rocketpie/tinyups/docs/architecture.md

# TinyUPS – Architecture (Draft)

> Status: **Draft.** Block topology is fixed by the design interview
> (see `docs/requirements.md`); component selection is still open.

## Block diagram

```mermaid
flowchart LR
    IN["A: 12 V in (XT60)\nexternal 240 W adapter"] --> PROT["Input protection\nfuse · TVS · OVP · reverse"]
    PROT --> PPM["Priority power path\ninput overrides pack"]
    PROT --> CHG["4S LFP charger\nbuck-boost CC/CV 13.8 V"]
    CHG <--> PACK["B: 4S1P LFP pack\n15 Ah + AFE/BMS"]
    PACK --> PPM
    PPM --> CONV["12 V buck-boost\nregulated 12.0 V"]
    CONV --> OUT["C: XT30 → 5.5×2.5 barrel\n→ picoPSU-160-XT"]
    AFE["AFE\ncell V · pack I · T\nbalancing · FETs"] <--> PACK
    AFE <--> MCU["RP2040\nSOC · logic · safety"]
    MCU --> USB["D: USB-C\nCDC + HID-PDC"]
    MCU --> IND["LEDs + reset button"]
    MCU --> FAN["80 mm fan\n4-pin: 12 V/PWM/tach"]
```

## Why this topology

- **Priority power path, not an ideal-diode OR.** A charged 4S LFP pack
  (~13.8 V) is *higher* than the 12 V input. A passive OR would let the pack
  supply the load even on mains and cycle the battery. The path must actively
  prefer the input whenever it is valid.
- **Always-regulated 12 V output.** The pack ranges from ~11.2 V to 13.8 V, so
  a buck-boost keeps the picoPSU inside its 10.8–13.2 V window at all times and
  hides adapter sag.
- **Buck-boost charger.** The pack sits both above and below 12 V depending on
  SOC, so a boost-only charger cannot regulate a low pack; a 4-switch
  buck-boost covers the whole range.
- **Two independent paths on mains** (load from input, pack charged in
  parallel) keep the transfer seamless and let the 20 A adapter run the load
  and charge simultaneously.
- **Pack-integrated BMS.** Per-cell sensing, protection and balancing live on
  the PCB so the module is self-contained and reports richer telemetry.

## Functional blocks

| Power Flow Order | Block | Task | Candidates |
| --- | --- | --- | --- |
| 1 | Input protection | Fuse, reverse-polarity, OVP, transient | Fuse + TVS + P-FET / eFuse |
| 2 | Charger | 4S LFP CC/CV to 13.8 V, temp-limited | 4-switch buck-boost charger IC |
| 3 | Priority power path | Prefer input, disconnect pack on mains | Power mux / back-to-back FETs + controller |
| 4 | Battery management | Cell V, pack I, T, balancing, protection FETs | BQ769x2-class AFE + dual N-FETs |
| 5 | Output converter | Regulated 12.0 V, ≥ 15 A | Synchronous buck-boost controller |
| 6 | Measurement | Output V/I, temperatures | AFE / INA226 + NTC |
| 6 | MCU | SOC, state machine, telemetry, signalling | RP2040 + QSPI flash |
| 6 | Host link | Telemetry + low-battery shutdown | USB-C composite CDC + HID-PDC |
| 6 | User interface | Status indication, reset | LEDs + button |
| 6 | Cooling | Temperature-controlled airflow | 80 mm fan, on-board 4-pin header |

ref: blocks.py

## Modes

1. **Mains, pack charged** – load from input, pack idle/float.
2. **Mains, pack charging** – load from input, charger in CC or CV.
3. **Backup** – input absent, pack feeds the buck-boost, no host reset.
4. **Low battery** – host warned at ≤ 30 % SOC; force-off at 3.0 V/cell.
5. **Off / storage** – output disabled, ≤ 1 mA from pack.

## Placement intent

Placement follows a written contract, not the netlist:
[`hardware/placement_spec.py`](../hardware/placement_spec.py) gives every part
a role and the limits (host, min/max, measure, reason) that follow from its
circuit function.  The power path is ordered input → protection → priority
path → converter → output; the charger and BMS are separate loops; switching
cells stay tight, the AFE/crystal/USB/harness stay away from the magnetics.
`make proximity` measures the board against it and `make place` uses the same
limits.  The measures, target families and per-block table are in
[`docs/placement.md`](placement.md); the decision is
[ADR-0016](decisions/0016-placement-intent.md).

The report prints every violated group and writes `reports/proximity.rpt`.  It
is a screen, not a CI gate by default; pass `--strict` to make it exit non-zero
(a missing role or host is always an error).

## Directory structure (planned)

```
hardware/
  tinyups.kicad_pro      # KiCad project
  tinyups.kicad_sch      # schematic (source of truth)
  tinyups.kicad_pcb      # board (source of truth)
  tinyups.kicad_dru      # design rules (JLCPCB)
  libs/                  # custom symbols
  blocks.py              # functional-block / reference map
  placement_spec.py      # roles + placement limits (design intent)
  power_*.py             # power spec, map, ampacity, pour, channel
  route.py               # FreeRouting driver
  route_feedback.py      # routed board + DRC -> placement-UI feedback JSON
ui/
  placement/             # interactive placement UI (browser)
mechanical/
  enclosure/             # ATX-bay enclosure (STEP/STL)
firmware/
  ...                    # RP2040 firmware (Pico SDK / PlatformIO)
sim/
  *.cir                  # ngspice netlists
tests/
  test_*.py              # pytest + PyVISA bring-up / acceptance
docs/
  requirements.md
  architecture.md
  bom.md
  test-plan.md
  history/layout_poc/    # archived automatic-placement PoC
  datasheets/            # vendor datasheets + source register
  decisions/
```

## Key design decisions

- Priority (active) power path instead of ideal-diode OR.
- Separate loops for charging and output conversion.
- Pack-integrated AFE for telemetry and safety.
- Telemetry and shutdown on a dedicated MCU, independent of host software.
- USB composite device: CDC for tooling, HID-PDC for native OS/NUT support.
- All checks headless via CLI (`kicad-cli`, KiBot, ngspice) for CI and
  agent support.

See `docs/decisions/0002`–`0006` for the recorded choices.
