rocketpie/tinyups/hardware/tinyups.kicad_pcb

## KiCad design hardware/tinyups.kicad_pcb (2026-10-20)

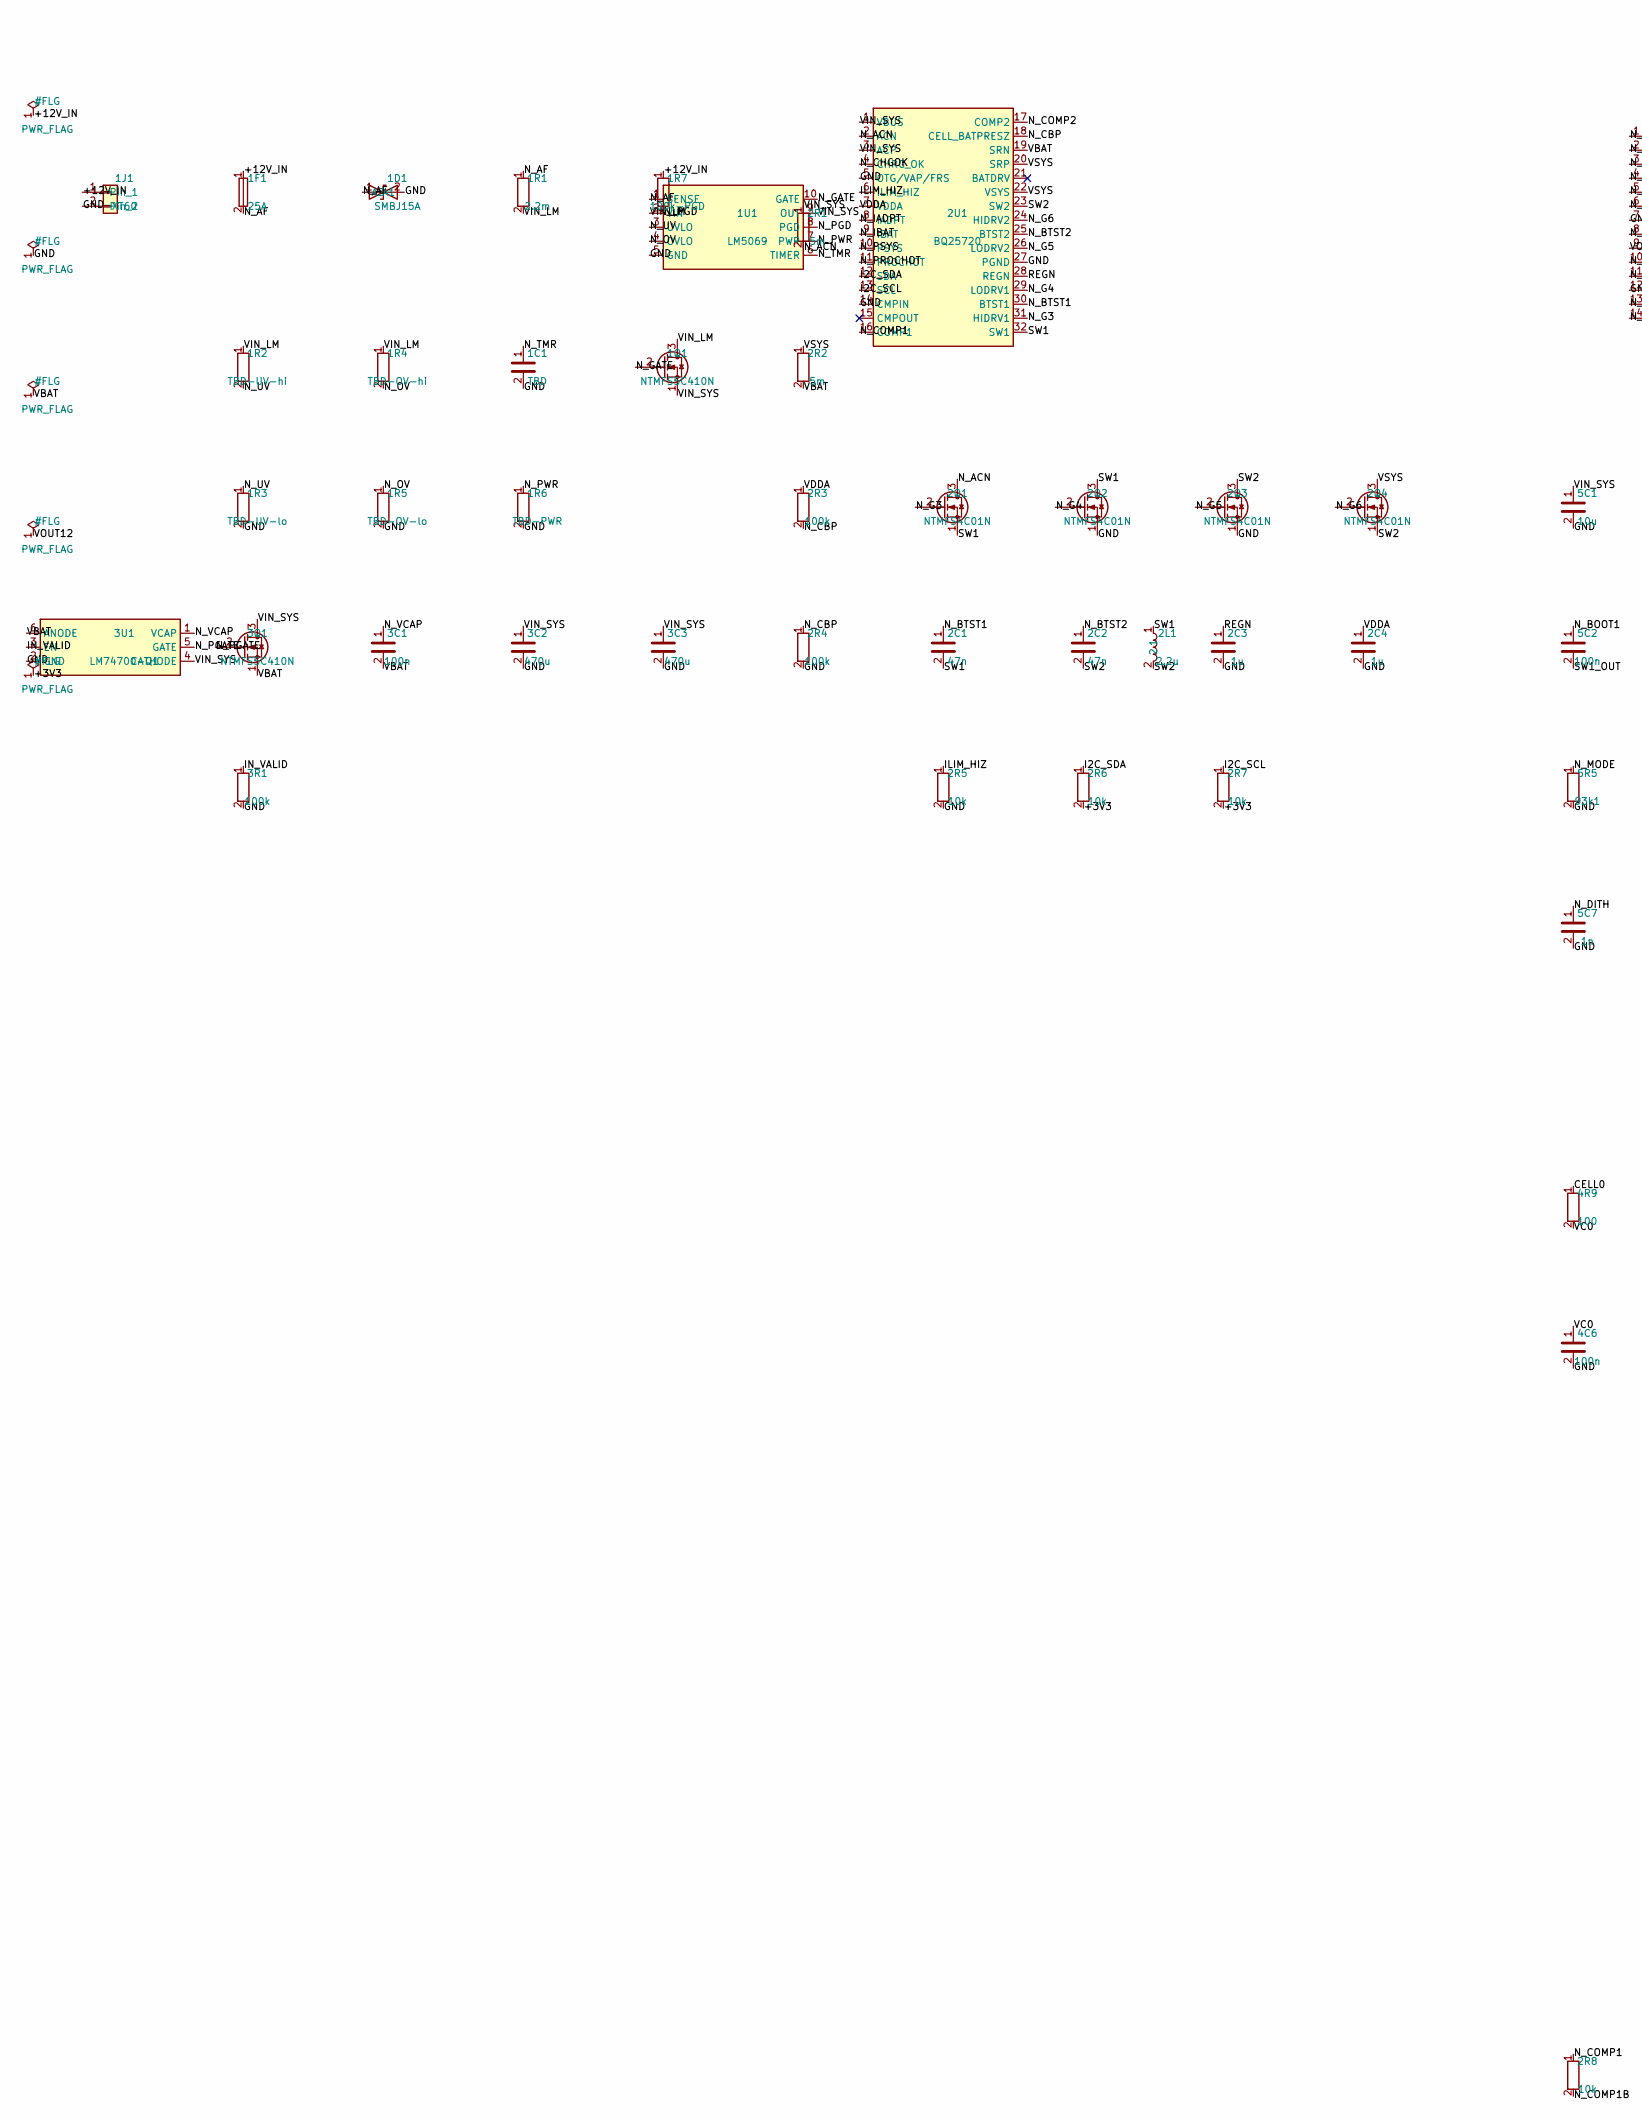
[picture p1: schematic tinyups.kicad_sch, part in row 1, column 1]

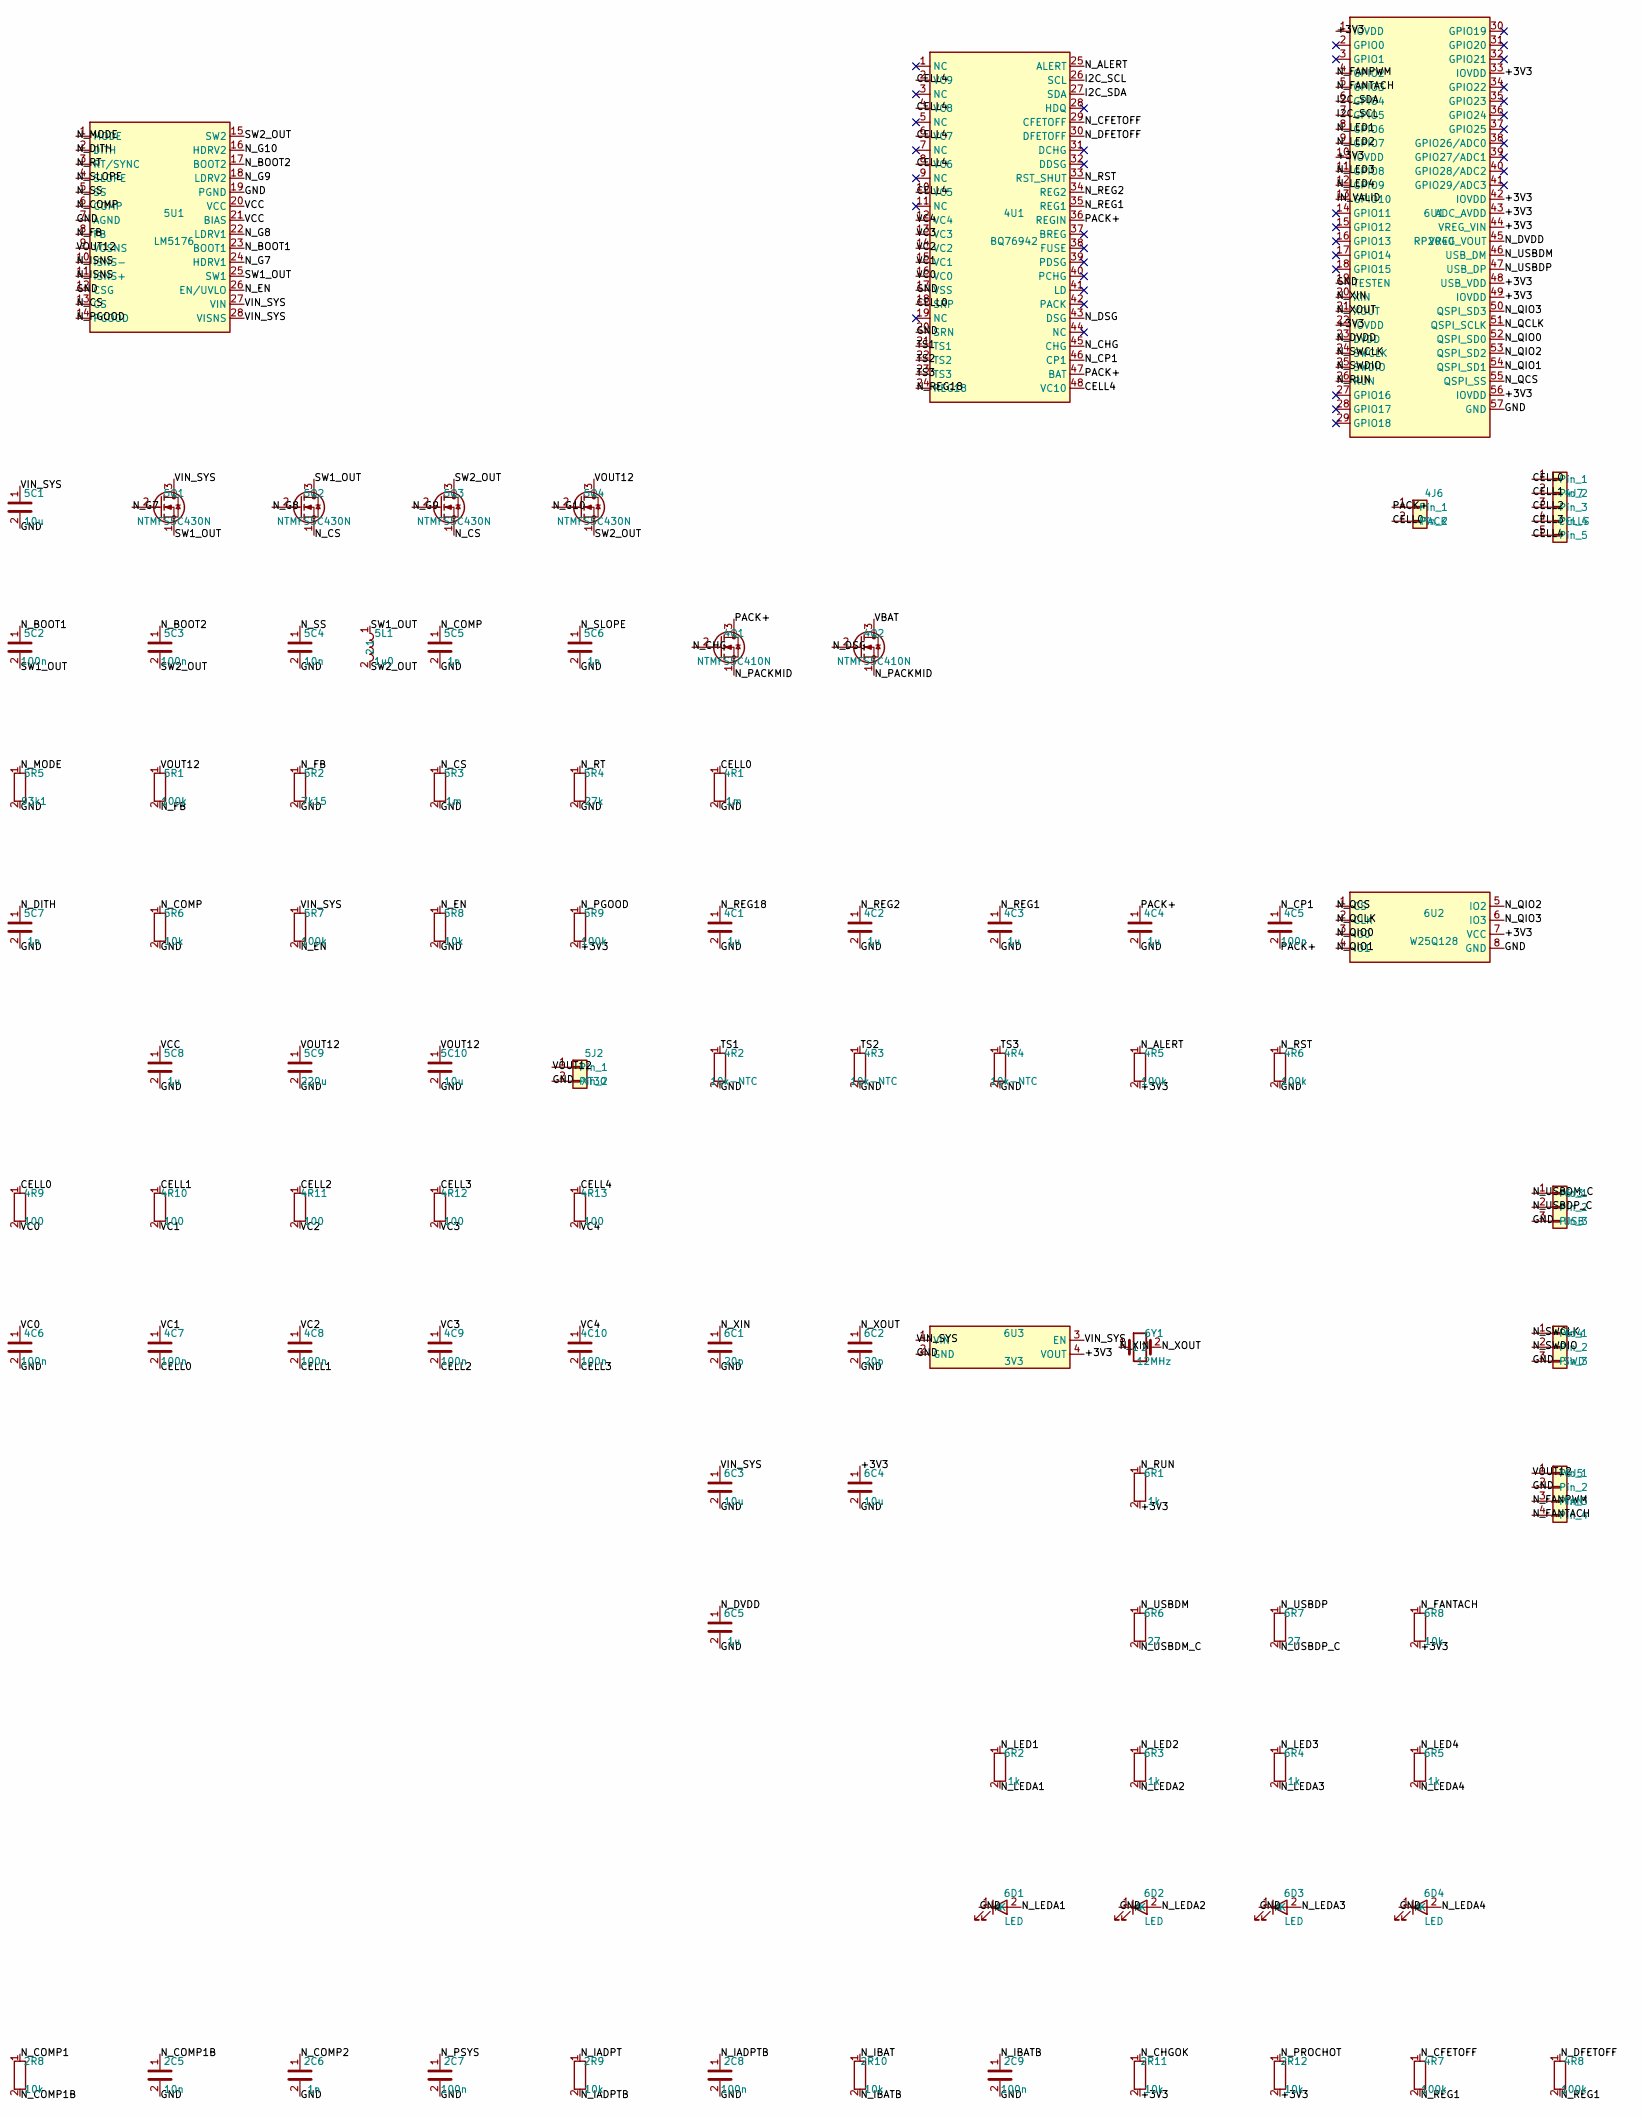
[picture p2: schematic tinyups.kicad_sch, part in row 1, column 2]

Parts:
1C1: TBD; C_0805_2012Metric
1D1: SMBJ15A; D_SMB
1F1: 25A; Fuse_Blade_ATO_directSolder
1J1: XT60; SolderWire-2.5sqmm_1x02_P8.8mm_D2.4mm_OD4.4mm
1Q1, 3Q1, 4Q1, 4Q2: NTMFS5C410N; VSONP-8-1EP_5x6_P1.27mm
1R1: 2.2m; R_Shunt_Vishay_WSR2_WSR3
1R2: TBD-UV-hi; R_0805_2012Metric
1R3: TBD-UV-lo; R_0805_2012Metric
1R4: TBD-OV-hi; R_0805_2012Metric
1R5: TBD-OV-lo; R_0805_2012Metric
1R6: TBD-PWR; R_0805_2012Metric
1R7: 100k-PGD; R_0805_2012Metric
1U1: LM5069; VSSOP-10_3x3mm_P0.5mm
2C1, 2C2: 47n; C_0805_2012Metric
2C3, 2C4, 4C1, 4C2, 4C3, 4C4, 5C8, 6C5: 1u; C_0805_2012Metric
2C5, 5C4: 10n; C_0805_2012Metric
2C6, 5C5, 5C6, 5C7: 1n; C_0805_2012Metric
2C7, 2C8, 2C9, 3C1, 4C5, 4C6, 4C7, 4C8, 4C9, 4C10, 5C2, 5C3: 100n; C_0805_2012Metric
2L1: 2.2u; L_12x12mm_H8mm
2Q1, 2Q2, 2Q3, 2Q4: NTMFS4C01N; VSONP-8-1EP_5x6_P1.27mm
2R1, 2R2: 5m; R_Shunt_Vishay_WSR2_WSR3
2R3, 2R4, 3R1, 4R5, 4R6, 4R7, 4R8, 5R1, 5R7, 5R9: 100k; R_0805_2012Metric
2R5, 2R6, 2R7, 2R8, 2R9, 2R10, 2R11, 2R12, 5R6, 5R8, 6R8: 10k; R_0805_2012Metric
2U1: BQ25720; QFN-32-1EP_4x4mm_P0.4mm_EP2.65x2.65mm
3C2, 3C3: 470u; CP_Elec_8x10
3U1: LM74700-Q1; SOT-23-6
4J6: PACK; SolderWire-2.5sqmm_1x02_P8.8mm_D2.4mm_OD4.4mm
4J7: CELLS; PinHeader_1x05_P2.54mm_Vertical
4R1, 5R3: 1m; R_Shunt_Vishay_WSR2_WSR3
4R2, 4R3, 4R4: 10k-NTC; R_0805_2012Metric
4R9, 4R10, 4R11, 4R12, 4R13: 100; R_0805_2012Metric
4U1: BQ76942; TQFP-48_7x7mm_P0.5mm
5C1, 5C10, 6C3, 6C4: 10u; C_0805_2012Metric
5C9: 220u; CP_Elec_8x10
5J2: XT30; SolderWire-2.5sqmm_1x02_P7.2mm_D2.4mm_OD3.6mm
5L1: 1u0; L_12x12mm_H8mm
5Q1, 5Q2, 5Q3, 5Q4: NTMFS5C430N; VSONP-8-1EP_5x6_P1.27mm
5R2: 7k15; R_0805_2012Metric
5R4: 27k; R_0805_2012Metric
5R5: 93k1; R_0805_2012Metric
5U1: LM5176; QFN-28-1EP_4x4mm_P0.4mm_EP2.4x2.4mm
6C1, 6C2: 20p; C_0805_2012Metric
6D1, 6D2, 6D3, 6D4: LED; LED_0805_2012Metric
6J3: USB; PinHeader_1x03_P2.54mm_Vertical
6J4: SWD; PinHeader_1x03_P2.54mm_Vertical
6J5: FAN; PinHeader_1x04_P2.54mm_Vertical
6R1, 6R2, 6R3, 6R4, 6R5: 1k; R_0805_2012Metric
6R6, 6R7: 27; R_0805_2012Metric
6U1: RP2040; QFN-56-1EP_7x7mm_P0.4mm_EP3.2x3.2mm
6U2: W25Q128; SOIC-8_3.9x4.9mm_P1.27mm
6U3: 3V3; SOT-23-5
6Y1: 12MHz; Crystal_SMD_5032-2Pin_5.0x3.2mm

Connections:
/+3V3: 2R6.2, 2R7.2, 2R11.2, 2R12.2, 4R5.2, 5R9.2, 6C4.1, 6R1.2, 6R8.2, 6U1.1 (IOVDD), 6U1.10 (IOVDD), 6U1.22 (IOVDD), 6U1.33 (IOVDD), 6U1.42 (IOVDD), 6U1.43 (ADC_AVDD), 6U1.44 (VREG_VIN), 6U1.48 (USB_VDD), 6U1.49 (IOVDD), 6U1.56 (IOVDD), 6U2.7 (VCC), 6U3.4 (VOUT)
/+12V_IN: 1F1.1, 1J1.1, 1R7.1
/CELL0: 4C7.2, 4J6.2, 4J7.1, 4R1.1, 4R9.1, 4U1.18 (SRP)
/CELL1: 4C8.2, 4J7.2, 4R10.1
/CELL2: 4C9.2, 4J7.3, 4R11.1
/CELL3: 4C10.2, 4J7.4, 4R12.1
/CELL4: 4J7.5, 4R13.1, 4U1.2 (VC9), 4U1.4 (VC8), 4U1.6 (VC7), 4U1.8 (VC6), 4U1.10 (VC5), 4U1.48 (VC10)
/GND: 1C1.2, 1D1.2 (A2), 1J1.2, 1R3.2, 1R5.2, 1R6.2, 1U1.5 (GND), 2C3.2, 2C4.2, 2C5.2, 2C6.2, 2C7.2, 2C8.2, 2C9.2, 2Q2.1 (S), 2Q3.1 (S), 2R4.2, 2R5.2, 2U1.5 (OTG/VAP/FRS), 2U1.14 (CMPIN), 2U1.27 (PGND), 3C2.2, 3C3.2, 3R1.2, 3U1.2 (GND), 4C1.2, 4C2.2, 4C3.2, 4C4.2, 4C6.2, 4R1.2, 4R2.2, 4R3.2, 4R4.2, 4R6.2, 4U1.17 (VSS), 4U1.20 (SRN), 5C1.2, 5C4.2, 5C5.2, 5C6.2, 5C7.2, 5C8.2, 5C9.2, 5C10.2, 5J2.2, 5R2.2, 5R3.2, 5R4.2, 5R5.2, 5R6.2, 5R8.2, 5U1.7 (AGND), 5U1.12 (CSG), 5U1.19 (PGND), 6C1.2, 6C2.2, 6C3.2, 6C4.2, 6C5.2, 6D1.1 (K), 6D2.1 (K), 6D3.1 (K), 6D4.1 (K), 6J3.3, 6J4.3, 6J5.2, 6U1.19 (TESTEN), 6U1.57 (GND), 6U2.8 (GND), 6U3.2 (GND)
/I2C_SCL: 2R7.1, 2U1.13 (SCL), 4U1.26 (SCL), 6U1.7 (GPIO5)
/I2C_SDA: 2R6.1, 2U1.12 (SDA), 4U1.27 (SDA), 6U1.6 (GPIO4)
/ILIM_HIZ: 2R5.1, 2U1.6 (ILIM_HIZ)
/IN_VALID: 3R1.1, 3U1.3 (EN), 6U1.13 (GPIO10)
/N_ACN: 2Q1.3 (D), 2R1.2, 2U1.2 (ACN)
/N_AF: 1D1.1 (A1), 1F1.2, 1R1.1, 1U1.1 (SENSE)
/N_ALERT: 4R5.1, 4U1.25 (ALERT)
/N_BOOT1: 5C2.1, 5U1.23 (BOOT1)
/N_BOOT2: 5C3.1, 5U1.17 (BOOT2)
/N_BTST1: 2C1.1, 2U1.30 (BTST1)
/N_BTST2: 2C2.1, 2U1.25 (BTST2)
/N_CBP: 2R3.2, 2R4.1, 2U1.18 (CELL_BATPRESZ)
/N_CFETOFF: 4R7.1, 4U1.29 (CFETOFF)
/N_CHG: 4Q1.2 (G), 4U1.45 (CHG)
/N_CHGOK: 2R11.1, 2U1.4 (CHRG_OK)
/N_COMP: 5C5.1, 5R6.1, 5U1.6 (COMP)
/N_COMP1: 2R8.1, 2U1.16 (COMP1)
/N_COMP1B: 2C5.1, 2R8.2
/N_COMP2: 2C6.1, 2U1.17 (COMP2)
/N_CP1: 4C5.1, 4U1.46 (CP1)
/N_CS: 5Q2.1 (S), 5Q3.1 (S), 5R3.1, 5U1.13 (CS)
/N_DFETOFF: 4R8.1, 4U1.30 (DFETOFF)
/N_DITH: 5C7.1, 5U1.2 (DITH)
/N_DSG: 4Q2.2 (G), 4U1.43 (DSG)
/N_DVDD: 6C5.1, 6U1.23 (DVDD), 6U1.45 (VREG_VOUT)
/N_EN: 5R7.2, 5R8.1, 5U1.26 (EN/UVLO)
/N_FANPWM: 6J5.3, 6U1.4 (GPIO2)
/N_FANTACH: 6J5.4, 6R8.1, 6U1.5 (GPIO3)
/N_FB: 5R1.2, 5R2.1, 5U1.8 (FB)
/N_G3: 2Q1.2 (G), 2U1.31 (HIDRV1)
/N_G4: 2Q2.2 (G), 2U1.29 (LODRV1)
/N_G5: 2Q3.2 (G), 2U1.26 (LODRV2)
/N_G6: 2Q4.2 (G), 2U1.24 (HIDRV2)
/N_G7: 5Q1.2 (G), 5U1.24 (HDRV1)
/N_G8: 5Q2.2 (G), 5U1.22 (LDRV1)
/N_G9: 5Q3.2 (G), 5U1.18 (LDRV2)
/N_G10: 5Q4.2 (G), 5U1.16 (HDRV2)
/N_GATE: 1Q1.2 (G), 1U1.10 (GATE)
/N_IADPT: 2R9.1, 2U1.8 (IADPT)
/N_IADPTB: 2C8.1, 2R9.2
/N_IBAT: 2R10.1, 2U1.9 (IBAT)
/N_IBATB: 2C9.1, 2R10.2
/N_ISNS: 5U1.10 (ISNS-), 5U1.11 (ISNS+)
/N_LED1: 6R2.1, 6U1.8 (GPIO6)
/N_LED2: 6R3.1, 6U1.9 (GPIO7)
/N_LED3: 6R4.1, 6U1.11 (GPIO8)
/N_LED4: 6R5.1, 6U1.12 (GPIO9)
/N_LEDA1: 6D1.2 (A), 6R2.2
/N_LEDA2: 6D2.2 (A), 6R3.2
/N_LEDA3: 6D3.2 (A), 6R4.2
/N_LEDA4: 6D4.2 (A), 6R5.2
/N_MODE: 5R5.1, 5U1.1 (MODE)
/N_OV: 1R4.2, 1R5.1, 1U1.4 (OVLO)
/N_PACKMID: 4Q1.1 (S), 4Q2.1 (S)
/N_PGATE: 3Q1.2 (G), 3U1.5 (GATE)
/N_PGD: 1R7.2, 1U1.8 (PGD)
/N_PGOOD: 5R9.1, 5U1.14 (PGOOD)
/N_PROCHOT: 2R12.1, 2U1.11 (PROCHOT)
/N_PSYS: 2C7.1, 2U1.10 (PSYS)
/N_PWR: 1R6.1, 1U1.7 (PWR)
/N_QCLK: 6U1.51 (QSPI_SCLK), 6U2.2 (CLK)
/N_QCS: 6U1.55 (QSPI_SS), 6U2.1 (CS)
/N_QIO0: 6U1.52 (QSPI_SD0), 6U2.3 (IO0)
/N_QIO1: 6U1.54 (QSPI_SD1), 6U2.4 (IO1)
/N_QIO2: 6U1.53 (QSPI_SD2), 6U2.5 (IO2)
/N_QIO3: 6U1.50 (QSPI_SD3), 6U2.6 (IO3)
/N_REG1: 4C3.1, 4R7.2, 4R8.2, 4U1.35 (REG1)
/N_REG2: 4C2.1, 4U1.34 (REG2)
/N_REG18: 4C1.1, 4U1.24 (REG18)
/N_RST: 4R6.1, 4U1.33 (RST_SHUT)
/N_RT: 5R4.1, 5U1.3 (RT/SYNC)
/N_RUN: 6R1.1, 6U1.26 (RUN)
/N_SLOPE: 5C6.1, 5U1.4 (SLOPE)
/N_SS: 5C4.1, 5U1.5 (SS)
/N_SWCLK: 6J4.1, 6U1.24 (SWCLK)
/N_SWDIO: 6J4.2, 6U1.25 (SWDIO)
/N_TMR: 1C1.1, 1U1.6 (TIMER)
/N_USBDM: 6R6.1, 6U1.46 (USB_DM)
/N_USBDM_C: 6J3.1, 6R6.2
/N_USBDP: 6R7.1, 6U1.47 (USB_DP)
/N_USBDP_C: 6J3.2, 6R7.2
/N_UV: 1R2.2, 1R3.1, 1U1.3 (UVLO)
/N_VCAP: 3C1.1, 3U1.1 (VCAP)
/N_XIN: 6C1.1, 6U1.20 (XIN), 6Y1.1
/N_XOUT: 6C2.1, 6U1.21 (XOUT), 6Y1.2
/PACK+: 4C4.1, 4C5.2, 4J6.1, 4Q1.3 (D), 4U1.36 (REGIN), 4U1.47 (BAT)
/REGN: 2C3.1, 2U1.28 (REGN)
/SW1: 2C1.2, 2L1.1, 2Q1.1 (S), 2Q2.3 (D), 2U1.32 (SW1)
/SW1_OUT: 5C2.2, 5L1.1, 5Q1.1 (S), 5Q2.3 (D), 5U1.25 (SW1)
/SW2: 2C2.2, 2L1.2, 2Q3.3 (D), 2Q4.1 (S), 2U1.23 (SW2)
/SW2_OUT: 5C3.2, 5L1.2, 5Q3.3 (D), 5Q4.1 (S), 5U1.15 (SW2)
/TS1: 4R2.1, 4U1.21 (TS1)
/TS2: 4R3.1, 4U1.22 (TS2)
/TS3: 4R4.1, 4U1.23 (TS3)
/VBAT: 2R2.2, 2U1.19 (SRN), 3C1.2, 3Q1.1 (S), 3U1.6 (ANODE), 4Q2.3 (D)
/VC0: 4C6.1, 4R9.2, 4U1.16 (VC0)
/VC1: 4C7.1, 4R10.2, 4U1.15 (VC1)
/VC2: 4C8.1, 4R11.2, 4U1.14 (VC2)
/VC3: 4C9.1, 4R12.2, 4U1.13 (VC3)
/VC4: 4C10.1, 4R13.2, 4U1.12 (VC4)
/VCC: 5C8.1, 5U1.20 (VCC), 5U1.21 (BIAS)
/VDDA: 2C4.1, 2R3.1, 2U1.7 (VDDA)
/VIN_LM: 1Q1.3 (D), 1R1.2, 1R2.1, 1R4.1, 1U1.2 (VIN)
/VIN_SYS: 1Q1.1 (S), 1U1.9 (OUT), 2R1.1, 2U1.1 (VBUS), 2U1.3 (ACP), 3C2.1, 3C3.1, 3Q1.3 (D), 3U1.4 (CATHODE), 5C1.1, 5Q1.3 (D), 5R7.1, 5U1.27 (VIN), 5U1.28 (VISNS), 6C3.1, 6U3.1 (VIN), 6U3.3 (EN)
/VOUT12: 5C9.1, 5C10.1, 5J2.1, 5Q4.3 (D), 5R1.1, 5U1.9 (VOSNS), 6J5.1
/VSYS: 2Q4.3 (D), 2R2.1, 2U1.20 (SRP), 2U1.22 (VSYS)

Board: 4 copper layers, 124 parts (0 on the bottom side), 114 nets, no tracks yet.
