rocketpie/tinyups/(commit log)

2026-10-11 add pcb design toolchain
2026-10-11 generated schematics
    [tinyups.kicad_sch]
2026-10-11 more work on hardware, routing
    [tinyups.kicad_pcb, tinyups.kicad_sch]
2026-10-11 work on routing
    [tinyups.kicad_pcb]
2026-10-11 more work on routing
    [tinyups.kicad_pcb]
2026-10-11 some more routing progress
    [tinyups.kicad_pcb]
2026-10-12 work on routing. llm hit wall
    [tinyups.kicad_pcb, tinyups.kicad_sch]
2026-10-12 add desktop-lite to use kicad gui
2026-10-13 add required kicad ui params to container.
2026-10-13 note amp issue
    [tinyups.kicad_pcb]
2026-10-13 found power limitations in design
2026-10-14 quantify power components, placement, add render for inspection
    [tinyups.kicad_pcb, tinyups.kicad_sch]
2026-10-14 refine placement calculation
    [tinyups.kicad_pcb]
2026-10-15 try to find a new placement approach
    [tinyups.kicad_pcb, tinyups.kicad_sch]
2026-10-17 try placing some boards
2026-10-18 work on board try5
2026-10-18 fix power pouring
2026-10-18 fix part selection
    [tinyups.kicad_sch]
2026-10-18 cleanup: adopt placement ui and board 'try5'. archive layout generator and poc
    [tinyups.kicad_pcb]
2026-10-18 fix drc rule file handling when copying a board
2026-10-19 fix placement with new ui features
    [tinyups.kicad_pcb]
2026-10-19 board fixup
2026-10-19 new terminal power rating metric, new FET selection
    [tinyups.kicad_pcb, tinyups.kicad_sch]
2026-10-19 board fixup, added shunt sense gate
    [tinyups.kicad_pcb, tinyups.kicad_sch]
2026-10-20 auto-work on resume
    [tinyups.kicad_pcb]
2026-10-20 fix power pour outlines
2026-10-20 add part proximity metrics
    [tinyups.kicad_pcb]
2026-10-20 (incomplete) voronoi pour overlap resolution
    [tinyups.kicad_pcb]
